Xtriker/Lector_RPM/Documentacion/Encoder.jpg

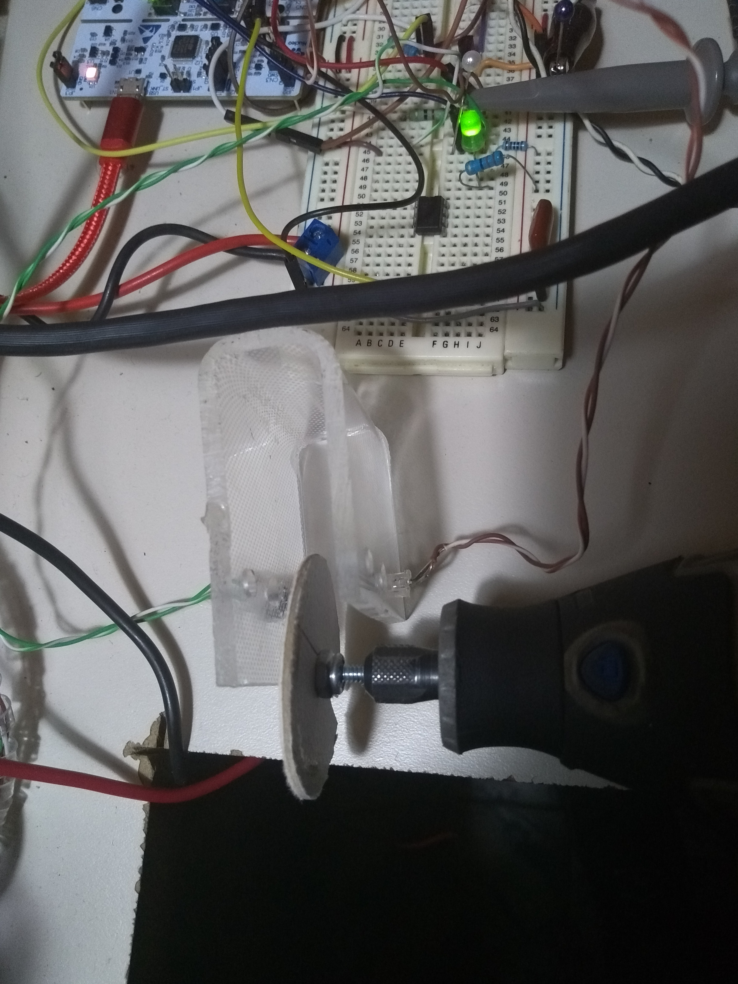
Documentacion/Encoder.jpg
