Xtriker/Lector_RPM/Documentacion/Lectura.jpg

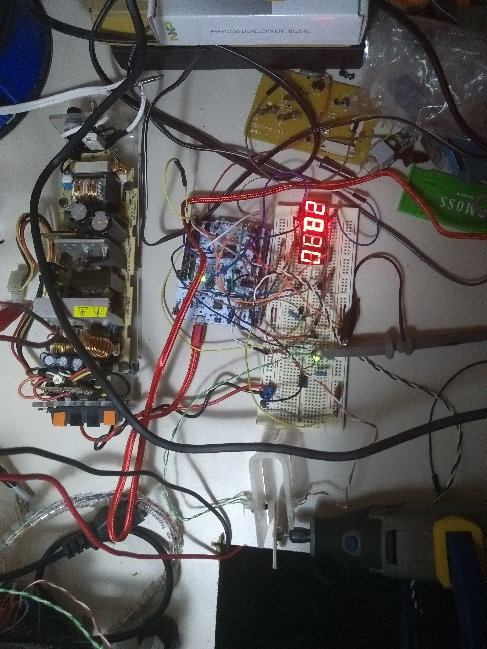
Documentacion/Lectura.jpg
