Xtriker/Lector_RPM/Documentacion/Esquematico.png

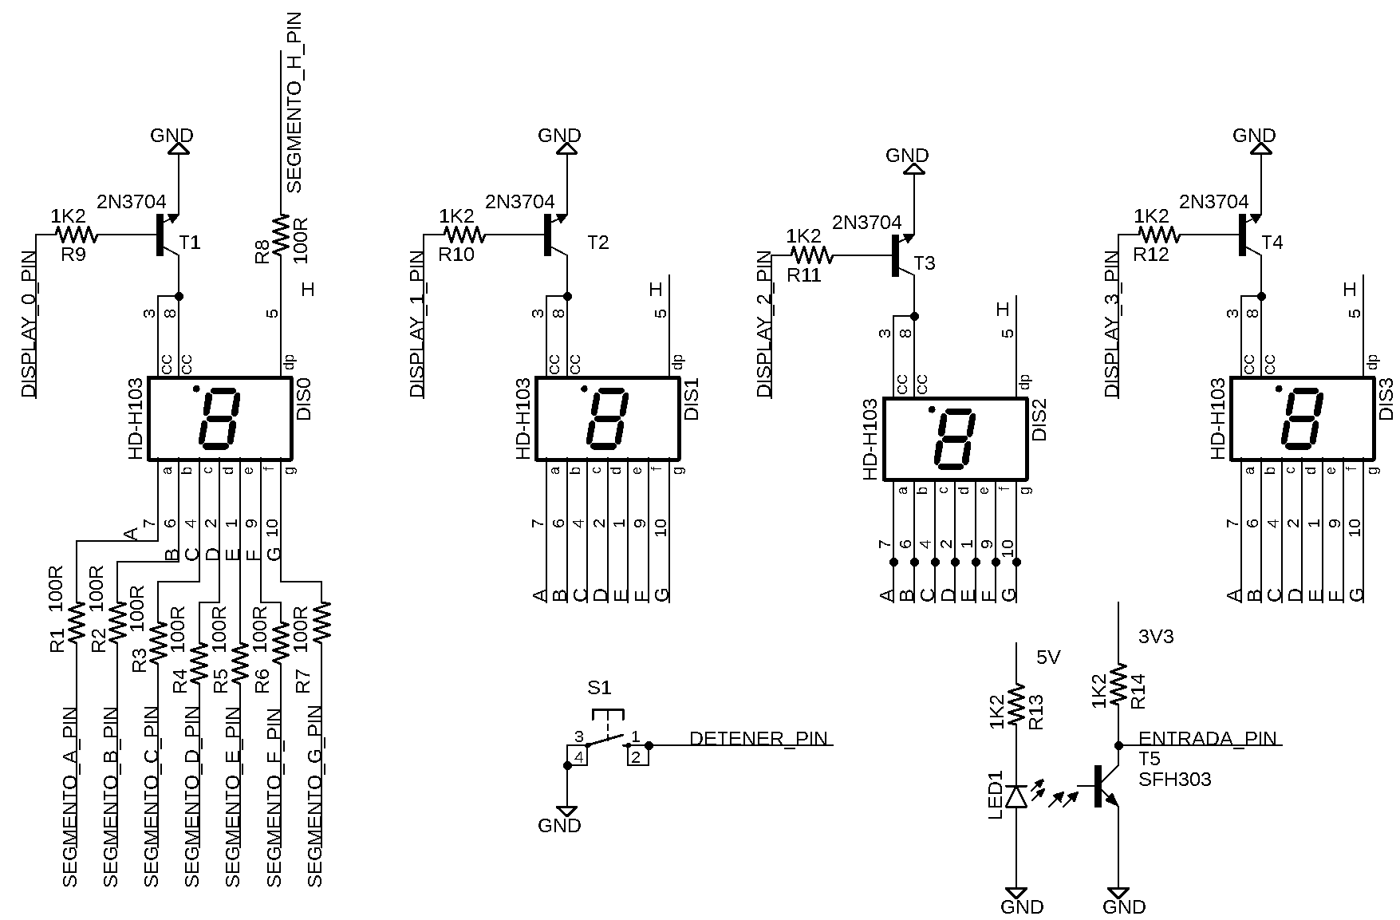
Documentacion/Esquematico.png
