Xtriker/Lector_RPM/Documentacion/IMG_20200613_205311_LL.jpg

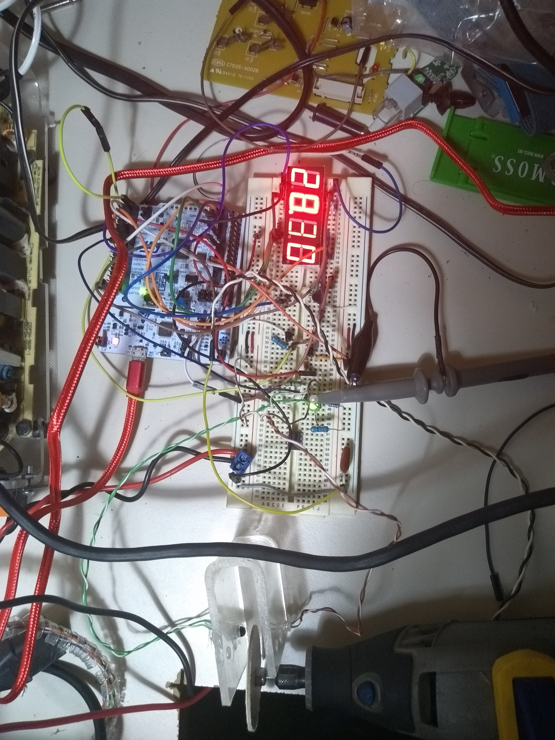
Documentacion/IMG_20200613_205311_LL.jpg
