Xtriker/Lector_RPM/Documentacion/Librerias.png

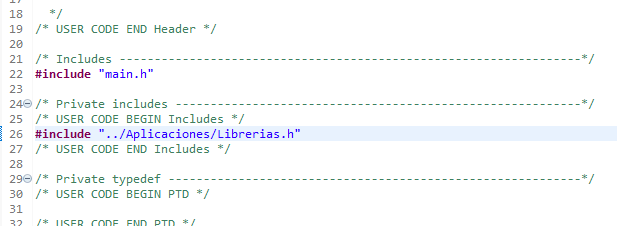
Documentacion/Librerias.png
