Xtriker/Lector_RPM/Documentacion/PIN_OUT.png

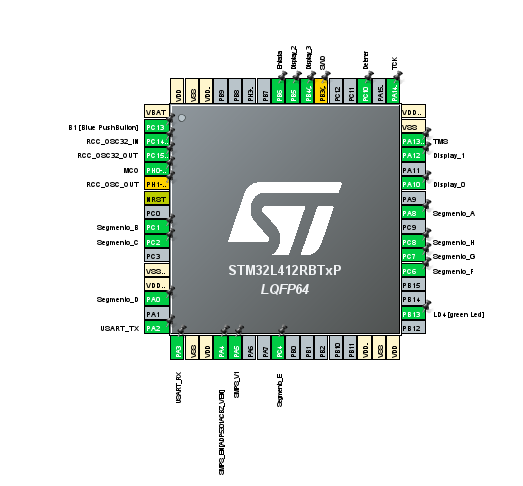
Documentacion/PIN_OUT.png
