Xtriker/Lector_RPM/Documentacion/Timer.png

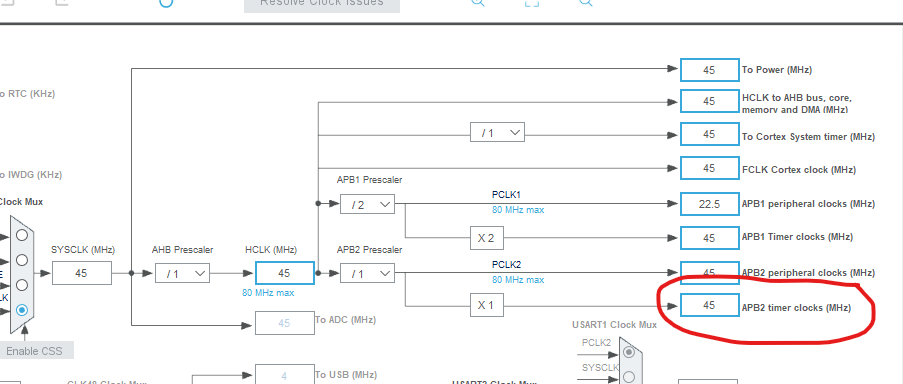
Documentacion/Timer.png
