Xtriker/Lector_RPM/Nucle-64-Template/STM32-Nucleo-F401RE-Dimensi.png

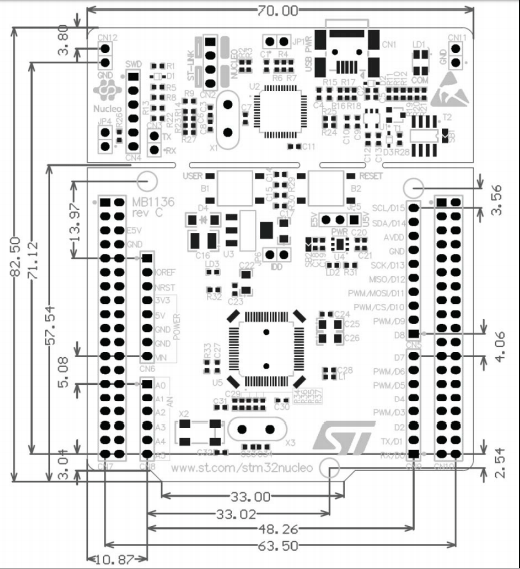
Nucle-64-Template/STM32-Nucleo-F401RE-Dimensi.png
