Xtriker/Lector_RPM/Documentacion/Curva_de_calibracion_frecuencia_vs_contador.ods

Hz | Contador 1us
20 | 49970 | 6255.8303561212 | 16.5546841464361
21 | 47590 | 5149.88924567352 | 18.4109547114658
22 | 47427 | 5080.05383219248 | 18.5454499022332
23 | 43452 | 3588.40142224915 | 22.1474977617652
24 | 41642 | 3031.72301653417 | 24.0118736901585
25 | 39976 | 2579.47229660204 | 25.8663314078583
26 | 38438 | 2209.16167197197 | 27.7052017611557
27 | 37015 | 1903.92559533439 | 29.5228036710998
30 | 33313 | 1260.11223473255 | 34.8297690131176
40 | 24985 | 429.774660765742 | 50.5191163300102
50 | 19988 | 210.963856136846 | 63.1484528349818
60 | 16656 | 137.475969805337 | 73.2791274527755
70 | 14277 | 110.945830610915 | 81.4922496657007
80 | 12492 | 103.246777688146 | 88.2536884074348
90 | 11104 | 104.297685583511 | 93.8967131754702
100 | 9994 | 109.768159636651 | -336.156169875886
150 | 6662 | 155.246623025318 | -324.053727660559
200 | 4997 | 198.808545965195 | -323.202847509546
250 | 3997 | 233.721211319753 | -301.494215569303
300 | 3331 | 261.255251626297 | -290.942408974155
350 | 2855 | 283.265259536837 | -280.816569149962
400 | 2498 | 301.145625761741 | -271.086854483398
450 | 2220 | 315.929902248766 | -261.731471689545
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
