Xtriker/Lector_RPM/Documentacion/Curva_de_calibracion_fase_vs_tiempo.ods

Angulo | Tiempo | Periodo
5 | 0.000231481481481 | 0.008333333333333
10 | 0.000462962962963
15 | 0.000694444444444
20 | 0.000925925925926
25 | 0.001157407407407
30 | 0.001388888888889
35 | 0.00162037037037
40 | 0.001851851851852
45 | 0.002083333333333
50 | 0.002314814814815
55 | 0.002546296296296
60 | 0.002777777777778
65 | 0.003009259259259
70 | 0.003240740740741
75 | 0.003472222222222
80 | 0.003703703703704
85 | 0.003935185185185
90 | 0.004166666666667
95 | 0.004398148148148
100 | 0.00462962962963
105 | 0.004861111111111
110 | 0.005092592592593
115 | 0.005324074074074
120 | 0.005555555555556
125 | 0.005787037037037
130 | 0.006018518518519
135 | 0.00625
140 | 0.006481481481481
145 | 0.006712962962963
150 | 0.006944444444444
155 | 0.007175925925926
160 | 0.007407407407407
165 | 0.007638888888889
170 | 0.00787037037037
175 | 0.008101851851852
180 | 0.008333333333333
