Xtriker/Lector_RPM/Documentacion/Nucle64-template.pdf

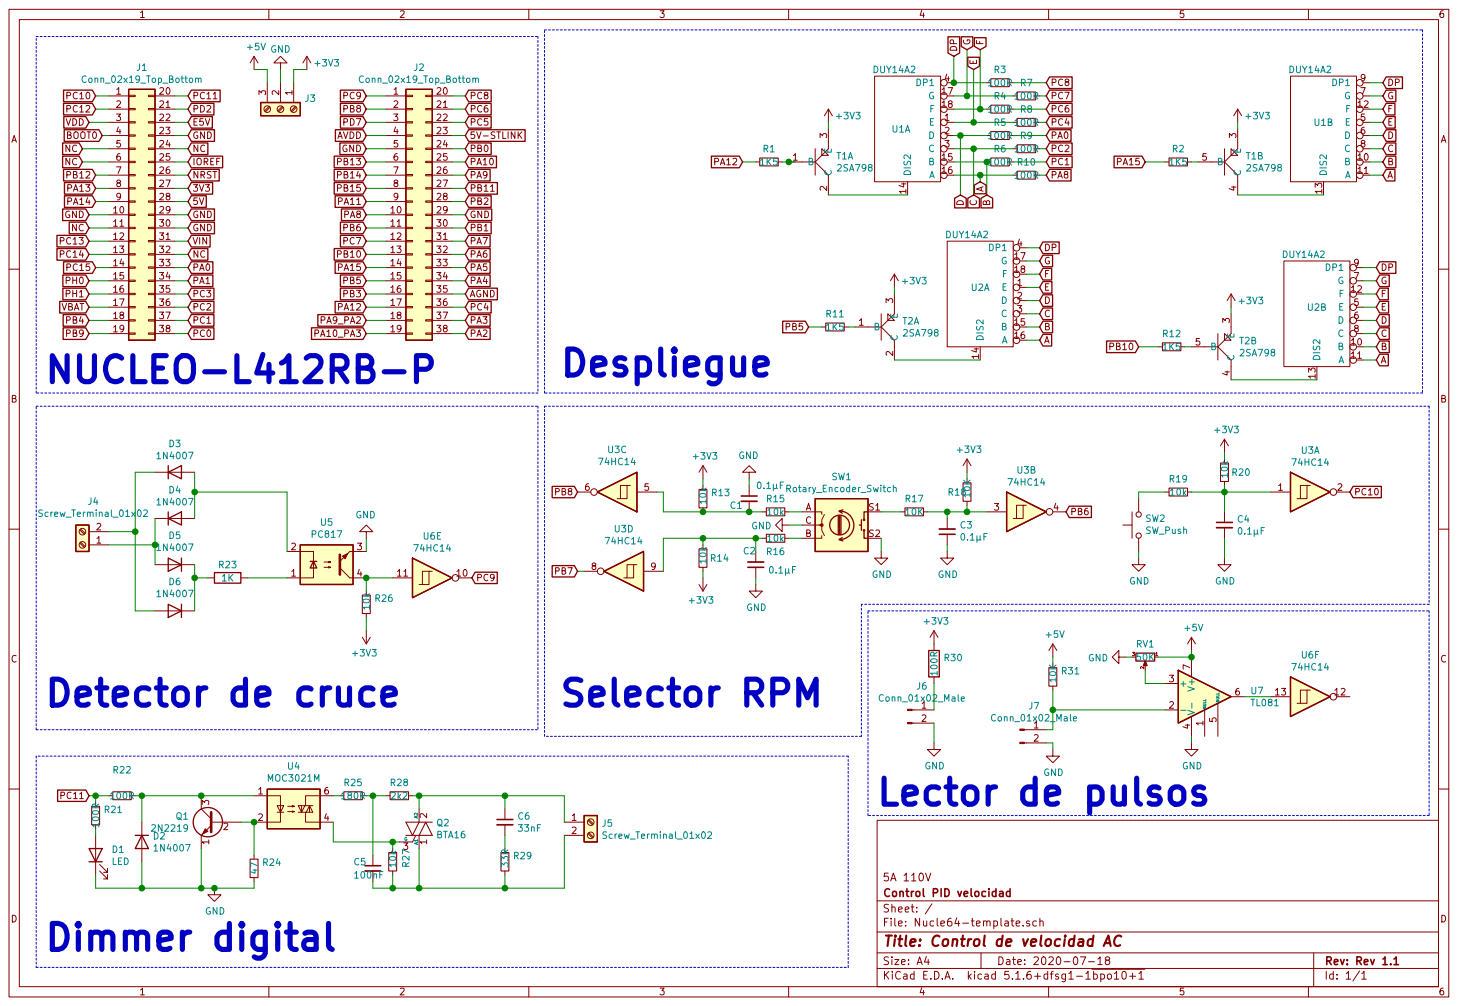
[picture p9: page 1]

File: Nucle64-template.sch Sheet: / Control PID velocidad 5A 110V

Id: 1/1 Title: Control de velocidad AC
