Xtriker/Lector_RPM/Nucle-64-Template/Nucle64-template/Nucle64-template.kicad_pcb

## KiCad design Nucle-64-Template/Nucle64-template/Nucle64-template.kicad_pcb (2020-07-22)

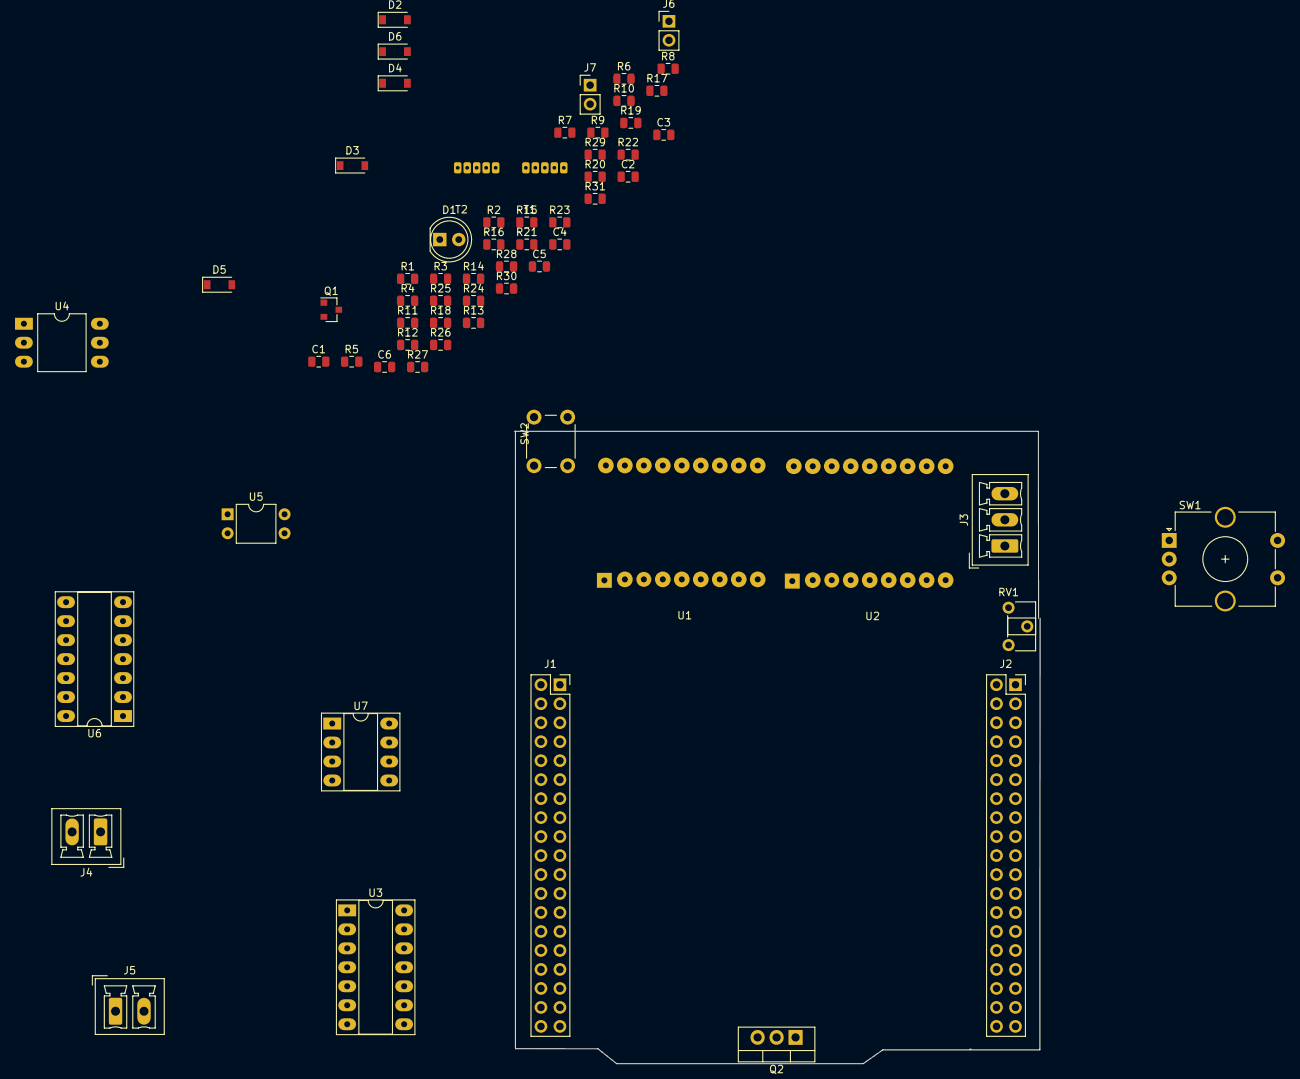
[picture p10: board Nucle64-template.kicad_pcb from above]

Board: 2 copper layers, 70.3 x 84.6 mm, 64 parts (0 on the bottom side), 64 nets, no tracks yet.

Parts:
C1, C2, C3, C4: 0.1µF; C_0805_2012Metric
C5: 100nF; C_0805_2012Metric
C6: 33nF; C_0805_2012Metric
D1: LED; LED_D5.0mm
D2, D3, D4, D5, D6: 1N4007; D_SOD-123
J1, J2: Conn_02x19_Top_Bottom; PinSocket_2x19_P2.54mm_Vertical
J3: Screw_Terminal_01x03; PhoenixContact_MCV_1,5_3-G-3.5_1x03_P3.50mm_Vertical
J4, J5: Screw_Terminal_01x02; PhoenixContact_MCV_1,5_2-G-3.81_1x02_P3.81mm_Vertical
J6, J7: Conn_01x02_Male; PinHeader_1x02_P2.54mm_Vertical
Q1: 2N2219; SOT-23
Q2: BTA16; TO-220-3_Vertical
R1, R2, R11, R12: 1K5; R_0805_2012Metric
R3, R4, R5, R6, R7, R8, R9, R10, R21, R22, R30: 100R; R_0805_2012Metric
R13, R14, R15, R16, R19, R20, R26, R27: 10k; R_0805_2012Metric
R17, R18, R31: 10K; R_0805_2012Metric
R23: 1K; R_0805_2012Metric
R24: 47; R_0805_2012Metric
R25: 180R; R_0805_2012Metric
R28: 2k2; R_0805_2012Metric
R29: 33R; R_0805_2012Metric
RV1: 50K; Potentiometer_ACP_CA6-H2,5_Horizontal
SW1: Rotary_Encoder_Switch; RotaryEncoder_Alps_EC12E-Switch_Vertical_H20mm_CircularMoun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
SW2: SW_Push; SW_PUSH_6mm
T1, T2: 2SA798
U1, U2: DUY14A2
U3, U6: 74HC14; DIP-14_W7.62mm_Socket_LongPads
U4: MOC3021M; DIP-6_W10.16mm_LongPads
U5: PC817; DIP-4_W7.62mm
U7: TL081; DIP-8_W7.62mm_Socket_LongPads

Connections:
+3V3: J3.1, R13.1, R14.2, R18.1, R20.1, R26.2, R30.1, T1.3, T2.3
+5V: J3.3, R31.1, RV1.1, U7.7
A: R10.2, U1.11, U1.16, U2.11, U2.16
B: R6.2, U1.10, U1.15, U2.10, U2.15
C: R9.2, U1.3, U1.8, U2.3, U2.8
D: R5.2, U1.2, U1.6, U2.2, U2.6
DP: R3.2, U1.4, U1.9, U2.4, U2.9
E: R8.2, U1.1, U1.5, U2.1, U2.5
F: R4.2, U1.12, U1.18, U2.12, U2.18
G: R7.2, U1.7, U1.17, U2.7, U2.17
GND: C1.1, C2.1, C3.1, C4.2, D1.1, D2.2, J1.10, J1.23, J1.29, J1.30, J2.5, J2.29, J3.2, J6.2, J7.2, Q1.1, R24.2, RV1.3, SW1.C, SW1.S2, SW2.1, U5.3, U7.4
NC: J1.5, J1.6, J1.11, J1.24, J1.32
unnamed: C1.2, R13.2, R15.2, U3.5
unnamed: C2.2, R14.1, R16.2, U3.9
unnamed: C3.2, R17.1, R18.2, U3.3
unnamed: C4.1, R19.1, R20.2, U3.1
unnamed: C5.1, R25.1, R28.2
unnamed: C5.2, J5.2, Q2.1, R27.2, R29.2
unnamed: C6.1, J5.1, Q2.2, R28.1
unnamed: C6.2, R29.1
unnamed: D1.2, R21.2
unnamed: D2.1, Q1.3, R22.1, U4.1
unnamed: D3.1, D6.2, J4.2
unnamed: D3.2, D4.2, U5.2
unnamed: D4.1, D5.2, J4.1
unnamed: D5.1, D6.1, R23.2
unnamed: J6.1, R30.2
unnamed: J7.1, R31.2, U7.2
unnamed: Q1.2, R24.1, U4.2
unnamed: Q2.3, R27.1, U4.4
unnamed: R1.1, T1.1
unnamed: R2.1, T1.5
unnamed: R11.1, T2.1
unnamed: R12.1, T2.5
unnamed: R15.1, SW1.A
unnamed: R16.1, SW1.B
unnamed: R17.2, SW1.S1
unnamed: R19.2, SW2.2
unnamed: R23.1, U5.1
unnamed: R25.2, U4.6
unnamed: R26.1, U5.4, U6.11
unnamed: RV1.2, U7.3
unnamed: T1.2, U1.14
unnamed: T1.4, U1.13
unnamed: T2.2, U2.14
unnamed: T2.4, U2.13
unnamed: U6.13, U7.6
PA0: J1.33, R5.1
PA8: J2.10, R10.1
PA12: J2.17, R1.2
PA15: J2.14, R2.2
PB5: J2.15, R11.2
PB6: J2.11, U3.4
PB8: J2.2, U3.6
PB10: J2.13, R12.2
PC1: J1.37, R6.1
PC2: J1.36, R9.1
PC4: J2.36, R8.1
PC6: J2.21, R4.1
PC7: J2.12, R7.1
PC8: J2.20, R3.1
PC9: J2.1, U6.10
PC10: J1.1, U3.2
PC11: J1.20, R21.1, R22.2
