Xtriker/Lector_RPM/Control_PID_STM32F103/Core/Src/main.c

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

/* Includes ------------------------------------------------------------------*/
#include "main.h"

/* USER CODE BEGIN Includes */
#include "../../Aplicaciones/app_Debounce.h"
#include "../../Aplicaciones/app_Delay.h"
#include "../../Aplicaciones/app_MAX7219.h"
/* USER CODE END Includes */

SPI_HandleTypeDef hspi1;

TIM_HandleTypeDef htim1;

void SystemClock_Config(void);
static void MX_GPIO_Init(void);
static void MX_TIM1_Init(void);
static void MX_SPI1_Init(void);
/**
  * @brief  The application entry point.
  * @retval int
  */
int main(void)
{
  /* MCU Configuration--------------------------------------------------------*/

  /* Reset of all peripherals, Initializes the Flash interface and the Systick. */
  HAL_Init();

  /* Configure the system clock */
  SystemClock_Config();

  /* Initialize all configured peripherals */
  MX_GPIO_Init();
  MX_TIM1_Init();
  MX_SPI1_Init();
  /* USER CODE BEGIN 2 */
  __HAL_SPI_ENABLE(&hspi1);
  HAL_TIM_Base_Start_IT(&htim1);
  app_InitMAX7219();
  /* USER CODE END 2 */

  /* Infinite loop */
  /* USER CODE BEGIN WHILE */
  /* Se manda la direccion del Boton */
  uint16_t Boton[3] = {0x1000, 0x2000, 0x4000};

  while (1)
  {
	  app_Debounce(Boton, 2);
	  app_SeleccionarAngulo();
	  app_NumeroAMAX7219(Total, 4);
    /* USER CODE END WHILE */

    /* USER CODE BEGIN 3 */
  }
  /* USER CODE END 3 */
}

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
