Xtriker/Lector_RPM/Control_PID_STM32F103/Core/Inc/main.h

#define LED_Pin GPIO_PIN_13
#define LED_GPIO_Port GPIOC
#define CSS_Pin GPIO_PIN_4
#define CSS_GPIO_Port GPIOA
#define Boton0_Pin GPIO_PIN_12
#define Boton0_GPIO_Port GPIOB
#define Boton1_Pin GPIO_PIN_13
#define Boton1_GPIO_Port GPIOB
#define Boton2_Pin GPIO_PIN_14
#define Boton2_GPIO_Port GPIOB
