Xtriker/Lector_RPM/PID_Spindle_Controller/Core/Aplicaciones/app_Despliegue.c

/* Libreria realizada por Adrián Darío Díaz López */
/* Libreria necesaria para el funcionamiento de la libreria */
/* La libreria es para display de 7 segmentos de catodo comun
 * si se quiere usar para anodo es necesario cambiar los 0 por
 * los unos en la funcion app_NumeroA7Segmentos, app_SeleccionDisplay
 * app_FloatADisplay y app_LetrasADisplay.
 */
#include "app_Despliegue.h"

/* Variables globales */
uint8_t Bandera[]={0,0,0};

/* Conversion del valor numerico para 7 segmentos */
void app_NumeroA7Segmentos(uint8_t Numero)
{
	switch(Numero)
	{
		case 0:
		{
			HAL_GPIO_WritePin(Segmento_A_GPIO_Port, Segmento_A_Pin, 1);
			HAL_GPIO_WritePin(Segmento_B_GPIO_Port, Segmento_B_Pin, 1);
			HAL_GPIO_WritePin(Segmento_C_GPIO_Port, Segmento_C_Pin, 1);
			HAL_GPIO_WritePin(Segmento_D_GPIO_Port, Segmento_D_Pin, 1);
			HAL_GPIO_WritePin(Segmento_E_GPIO_Port, Segmento_E_Pin, 1);
			HAL_GPIO_WritePin(Segmento_F_GPIO_Port, Segmento_F_Pin, 1);
			HAL_GPIO_WritePin(Segmento_G_GPIO_Port, Segmento_G_Pin, 0);

		}break;
		case 1:
		{
			HAL_GPIO_WritePin(Segmento_A_GPIO_Port, Segmento_A_Pin, 0);
			HAL_GPIO_WritePin(Segmento_B_GPIO_Port, Segmento_B_Pin, 1);
			HAL_GPIO_WritePin(Segmento_C_GPIO_Port, Segmento_C_Pin, 1);
			HAL_GPIO_WritePin(Segmento_D_GPIO_Port, Segmento_D_Pin, 0);
			HAL_GPIO_WritePin(Segmento_E_GPIO_Port, Segmento_E_Pin, 0);
			HAL_GPIO_WritePin(Segmento_F_GPIO_Port, Segmento_F_Pin, 0);
			HAL_GPIO_WritePin(Segmento_G_GPIO_Port, Segmento_G_Pin, 0);
		}break;
		case 2:
		{
			HAL_GPIO_WritePin(Segmento_A_GPIO_Port, Segmento_A_Pin, 1);
			HAL_GPIO_WritePin(Segmento_B_GPIO_Port, Segmento_B_Pin, 1);
			HAL_GPIO_WritePin(Segmento_C_GPIO_Port, Segmento_C_Pin, 0);
			HAL_GPIO_WritePin(Segmento_D_GPIO_Port, Segmento_D_Pin, 1);
			HAL_GPIO_WritePin(Segmento_E_GPIO_Port, Segmento_E_Pin, 1);
			HAL_GPIO_WritePin(Segmento_F_GPIO_Port, Segmento_F_Pin, 0);
			HAL_GPIO_WritePin(Segmento_G_GPIO_Port, Segmento_G_Pin, 1);
		}break;
		case 3:
		{
			HAL_GPIO_WritePin(Segmento_A_GPIO_Port, Segmento_A_Pin, 1);
			HAL_GPIO_WritePin(Segmento_B_GPIO_Port, Segmento_B_Pin, 1);
			HAL_GPIO_WritePin(Segmento_C_GPIO_Port, Segmento_C_Pin, 1);
			HAL_GPIO_WritePin(Segmento_D_GPIO_Port, Segmento_D_Pin, 1);
			HAL_GPIO_WritePin(Segmento_E_GPIO_Port, Segmento_E_Pin, 0);
			HAL_GPIO_WritePin(Segmento_F_GPIO_Port, Segmento_F_Pin, 0);
			HAL_GPIO_WritePin(Segmento_G_GPIO_Port, Segmento_G_Pin, 1);
		}break;
		case 4:
		{
			HAL_GPIO_WritePin(Segmento_A_GPIO_Port, Segmento_A_Pin, 0);
			HAL_GPIO_WritePin(Segmento_B_GPIO_Port, Segmento_B_Pin, 1);
			HAL_GPIO_WritePin(Segmento_C_GPIO_Port, Segmento_C_Pin, 1);
			HAL_GPIO_WritePin(Segmento_D_GPIO_Port, Segmento_D_Pin, 0);
			HAL_GPIO_WritePin(Segmento_E_GPIO_Port, Segmento_E_Pin, 0);
			HAL_GPIO_WritePin(Segmento_F_GPIO_Port, Segmento_F_Pin, 1);
			HAL_GPIO_WritePin(Segmento_G_GPIO_Port, Segmento_G_Pin, 1);
		}break;
		case 5:
		{
			HAL_GPIO_WritePin(Segmento_A_GPIO_Port, Segmento_A_Pin, 1);
			HAL_GPIO_WritePin(Segmento_B_GPIO_Port, Segmento_B_Pin, 0);
			HAL_GPIO_WritePin(Segmento_C_GPIO_Port, Segmento_C_Pin, 1);
			HAL_GPIO_WritePin(Segmento_D_GPIO_Port, Segmento_D_Pin, 1);
			HAL_GPIO_WritePin(Segmento_E_GPIO_Port, Segmento_E_Pin, 0);
			HAL_GPIO_WritePin(Segmento_F_GPIO_Port, Segmento_F_Pin, 1);
			HAL_GPIO_WritePin(Segmento_G_GPIO_Port, Segmento_G_Pin, 1);
		}break;
		case 6:
		{
			HAL_GPIO_WritePin(Segmento_A_GPIO_Port, Segmento_A_Pin, 1);
			HAL_GPIO_WritePin(Segmento_B_GPIO_Port, Segmento_B_Pin, 0);
			HAL_GPIO_WritePin(Segmento_C_GPIO_Port, Segmento_C_Pin, 1);
			HAL_GPIO_WritePin(Segmento_D_GPIO_Port, Segmento_D_Pin, 1);
			HAL_GPIO_WritePin(Segmento_E_GPIO_Port, Segmento_E_Pin, 1);
			HAL_GPIO_WritePin(Segmento_F_GPIO_Port, Segmento_F_Pin, 1);
			HAL_GPIO_WritePin(Segmento_G_GPIO_Port, Segmento_G_Pin, 1);
		}break;
		case 7:
		{
			HAL_GPIO_WritePin(Segmento_A_GPIO_Port, Segmento_A_Pin, 1);
			HAL_GPIO_WritePin(Segmento_B_GPIO_Port, Segmento_B_Pin, 1);
			HAL_GPIO_WritePin(Segmento_C_GPIO_Port, Segmento_C_Pin, 1);
			HAL_GPIO_WritePin(Segmento_D_GPIO_Port, Segmento_D_Pin, 0);
			HAL_GPIO_WritePin(Segmento_E_GPIO_Port, Segmento_E_Pin, 0);
			HAL_GPIO_WritePin(Segmento_F_GPIO_Port, Segmento_F_Pin, 0);
			HAL_GPIO_WritePin(Segmento_G_GPIO_Port, Segmento_G_Pin, 1);
		}break;
		case 8:
		{
			HAL_GPIO_WritePin(Segmento_A_GPIO_Port, Segmento_A_Pin, 1);
			HAL_GPIO_WritePin(Segmento_B_GPIO_Port, Segmento_B_Pin, 1);
			HAL_GPIO_WritePin(Segmento_C_GPIO_Port, Segmento_C_Pin, 1);
			HAL_GPIO_WritePin(Segmento_D_GPIO_Port, Segmento_D_Pin, 1);
			HAL_GPIO_WritePin(Segmento_E_GPIO_Port, Segmento_E_Pin, 1);
			HAL_GPIO_WritePin(Segmento_F_GPIO_Port, Segmento_F_Pin, 1);
			HAL_GPIO_WritePin(Segmento_G_GPIO_Port, Segmento_G_Pin, 1);
		}break;
		case 9:
		{
			HAL_GPIO_WritePin(Segmento_A_GPIO_Port, Segmento_A_Pin, 1);
			HAL_GPIO_WritePin(Segmento_B_GPIO_Port, Segmento_B_Pin, 1);
			HAL_GPIO_WritePin(Segmento_C_GPIO_Port, Segmento_C_Pin, 1);
			HAL_GPIO_WritePin(Segmento_D_GPIO_Port, Segmento_D_Pin, 1);
			HAL_GPIO_WritePin(Segmento_E_GPIO_Port, Segmento_E_Pin, 0);
			HAL_GPIO_WritePin(Segmento_F_GPIO_Port, Segmento_F_Pin, 1);
			HAL_GPIO_WritePin(Segmento_G_GPIO_Port, Segmento_G_Pin, 1);
		}break;
		default:
		{

			/*No hace nada */
		}
	}
}

/* Seleccion del display, su uso es para 4 displays de 7 segmentos */
/* Es necesario el usado de transistores */
void app_SeleccionDisplay(uint8_t Display)
{
	switch(Display)
	{
		case 0:
			{
				HAL_GPIO_WritePin(Display_0_GPIO_Port, Display_0_Pin, 1);
				HAL_GPIO_WritePin(Display_1_GPIO_Port, Display_1_Pin, 0);
				HAL_GPIO_WritePin(Display_2_GPIO_Port, Display_2_Pin, 0);
				HAL_GPIO_WritePin(Display_3_GPIO_Port, Display_3_Pin, 0);
			}break;
		case 1:
			{
				HAL_GPIO_WritePin(Display_0_GPIO_Port, Display_0_Pin, 0);
				HAL_GPIO_WritePin(Display_1_GPIO_Port, Display_1_Pin, 1);
				HAL_GPIO_WritePin(Display_2_GPIO_Port, Display_2_Pin, 0);
				HAL_GPIO_WritePin(Display_3_GPIO_Port, Display_3_Pin, 0);
			}break;
		case 2:
			{
				HAL_GPIO_WritePin(Display_0_GPIO_Port, Display_0_Pin, 0);
				HAL_GPIO_WritePin(Display_1_GPIO_Port, Display_1_Pin, 0);
				HAL_GPIO_WritePin(Display_2_GPIO_Port, Display_2_Pin, 1);
				HAL_GPIO_WritePin(Display_3_GPIO_Port, Display_3_Pin, 0);
			}break;
		case 3:
			{
				HAL_GPIO_WritePin(Display_0_GPIO_Port, Display_0_Pin, 0);
				HAL_GPIO_WritePin(Display_1_GPIO_Port, Display_1_Pin, 0);
				HAL_GPIO_WritePin(Display_2_GPIO_Port, Display_2_Pin, 0);
				HAL_GPIO_WritePin(Display_3_GPIO_Port, Display_3_Pin, 1);
			}break;
		default:
		{
			/* Envia todos los displays a 1 logicos */
			HAL_GPIO_WritePin(Display_0_GPIO_Port, Display_0_Pin, 1);
			HAL_GPIO_WritePin(Display_1_GPIO_Port, Display_1_Pin, 1);
			HAL_GPIO_WritePin(Display_2_GPIO_Port, Display_2_Pin, 1);
			HAL_GPIO_WritePin(Display_3_GPIO_Port, Display_3_Pin, 1);
		}
	}
}

/* Separacion de numero en unidades, decenas, centenas ... */
void app_Despliegue(uint16_t Numero)
{
	uint8_t Primero  =  Numero % 10;
	uint8_t Segundo =  ( Numero - Primero ) % 100 / 10;
	uint8_t Tercero  =  ( Numero - Primero - Segundo ) % 1000 / 100;
	uint8_t Cuarto =  ( Numero - Primero - Segundo - Tercero ) % 10000 / 1000;
	uint8_t Quinto = (Numero - Primero - Segundo - Tercero - Cuarto) % 100000 / 10000;
	if (Numero > 9999)
	{
		HAL_GPIO_WritePin(Segmento_H_GPIO_Port, Segmento_H_Pin, 0);
		app_SeleccionDisplay(0);
		app_NumeroA7Segmentos(Quinto);
		HAL_Delay(3);

		app_SeleccionDisplay(1);
		app_NumeroA7Segmentos(Cuarto);

		HAL_Delay(3);
		app_SeleccionDisplay(2);
		app_NumeroA7Segmentos(Tercero);
		HAL_Delay(3);
		app_SeleccionDisplay(3);
		app_NumeroA7Segmentos(Segundo);
		HAL_Delay(3);
		app_SeleccionDisplay(1);
		//app_NumeroA7Segmentos(Cuarto);
		HAL_GPIO_WritePin(Segmento_H_GPIO_Port, Segmento_H_Pin, 1);
		HAL_Delay(3);

	}
	if(Numero < 9999)
	{


		HAL_GPIO_WritePin(Segmento_H_GPIO_Port, Segmento_H_Pin, 0);
		app_SeleccionDisplay(0);
		app_NumeroA7Segmentos(Cuarto);
		HAL_Delay(3);
		app_SeleccionDisplay(1);
		app_NumeroA7Segmentos(Tercero);
		HAL_Delay(3);
		app_SeleccionDisplay(2);
		app_NumeroA7Segmentos(Segundo);
		HAL_Delay(3);
		app_SeleccionDisplay(3);
		app_NumeroA7Segmentos(Primero);
		HAL_Delay(3);
		if(Bandera[0] == 1)
		{
			app_SeleccionDisplay(0);
			app_NumeroA7Segmentos(Cuarto);
			HAL_GPIO_WritePin(Segmento_H_GPIO_Port, Segmento_H_Pin, 1);
			HAL_Delay(3);
		}
		if(Bandera[1] == 1)
		{
			app_SeleccionDisplay(1);
			HAL_GPIO_WritePin(Segmento_H_GPIO_Port, Segmento_H_Pin, 1);
			app_NumeroA7Segmentos(Tercero);
			HAL_Delay(3);
		}
		if(Bandera[2] == 1)
		{
			app_SeleccionDisplay(2);
			HAL_GPIO_WritePin(Segmento_H_GPIO_Port, Segmento_H_Pin, 1);
			app_NumeroA7Segmentos(Segundo);
			HAL_Delay(3);
		}
	}

}

/* Conversion de datos flotantes a displays de 7 segmentos */
void app_FloatADisplay(float NumeroFlotante) //125.8
{
	volatile int Numero = 0;


	if( (NumeroFlotante > 0.0) && (NumeroFlotante < 10.0))
		{
			Bandera[0] = 1;
			Bandera[1] = 0;
			Bandera[2] = 0;
			Numero = NumeroFlotante * 1000;
		}
	else if( (NumeroFlotante > 10.0) && (NumeroFlotante < 100.0)) //54.87
		{
			Bandera[0] = 0;
			Bandera[1] = 1;
			Bandera[2] = 0;
			Numero = NumeroFlotante * 100; //5487
		}
	else if( (NumeroFlotante > 100.0) && (NumeroFlotante < 1000.0))
		{
			Bandera[0] = 0;
			Bandera[1] = 0;
			Bandera[2] = 1;
			Numero = NumeroFlotante * 10;
		}
	app_Despliegue(Numero);

}

/* Impresion de letras en display de 7 segmentos */
void app_LetrasADisplay(char Letras)
{
	//volatile uint8_t i=0;
	switch(Letras)
		{
			case 'A' | 'a':
			{
				HAL_GPIO_WritePin(Segmento_A_GPIO_Port, Segmento_A_Pin, 1);
				HAL_GPIO_WritePin(Segmento_B_GPIO_Port, Segmento_B_Pin, 1);
				HAL_GPIO_WritePin(Segmento_C_GPIO_Port, Segmento_C_Pin, 1);
				HAL_GPIO_WritePin(Segmento_D_GPIO_Port, Segmento_D_Pin, 0);
				HAL_GPIO_WritePin(Segmento_E_GPIO_Port, Segmento_E_Pin, 1);
				HAL_GPIO_WritePin(Segmento_F_GPIO_Port, Segmento_F_Pin, 1);
				HAL_GPIO_WritePin(Segmento_G_GPIO_Port, Segmento_G_Pin, 1);

			}break;
			case 'B' | 'b':
			{
				HAL_GPIO_WritePin(Segmento_A_GPIO_Port, Segmento_A_Pin, 0);
				HAL_GPIO_WritePin(Segmento_B_GPIO_Port, Segmento_B_Pin, 0);
				HAL_GPIO_WritePin(Segmento_C_GPIO_Port, Segmento_C_Pin, 1);
				HAL_GPIO_WritePin(Segmento_D_GPIO_Port, Segmento_D_Pin, 1);
				HAL_GPIO_WritePin(Segmento_E_GPIO_Port, Segmento_E_Pin, 1);
				HAL_GPIO_WritePin(Segmento_F_GPIO_Port, Segmento_F_Pin, 1);
				HAL_GPIO_WritePin(Segmento_G_GPIO_Port, Segmento_G_Pin, 1);
			}break;
			case 'C' | 'c':
			{
				HAL_GPIO_WritePin(Segmento_A_GPIO_Port, Segmento_A_Pin, 1);
				HAL_GPIO_WritePin(Segmento_B_GPIO_Port, Segmento_B_Pin, 0);
				HAL_GPIO_WritePin(Segmento_C_GPIO_Port, Segmento_C_Pin, 0);
				HAL_GPIO_WritePin(Segmento_D_GPIO_Port, Segmento_D_Pin, 1);
				HAL_GPIO_WritePin(Segmento_E_GPIO_Port, Segmento_E_Pin, 1);
				HAL_GPIO_WritePin(Segmento_F_GPIO_Port, Segmento_F_Pin, 1);
				HAL_GPIO_WritePin(Segmento_G_GPIO_Port, Segmento_G_Pin, 0);
			}break;
			case 'D' | 'd':
			{
				HAL_GPIO_WritePin(Segmento_A_GPIO_Port, Segmento_A_Pin, 0);
				HAL_GPIO_WritePin(Segmento_B_GPIO_Port, Segmento_B_Pin, 1);
				HAL_GPIO_WritePin(Segmento_C_GPIO_Port, Segmento_C_Pin, 1);
				HAL_GPIO_WritePin(Segmento_D_GPIO_Port, Segmento_D_Pin, 1);
				HAL_GPIO_WritePin(Segmento_E_GPIO_Port, Segmento_E_Pin, 1);
				HAL_GPIO_WritePin(Segmento_F_GPIO_Port, Segmento_F_Pin, 0);
				HAL_GPIO_WritePin(Segmento_G_GPIO_Port, Segmento_G_Pin, 1);
			}break;
			case 'E' | 'e':
			{
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
				HAL_GPIO_WritePin(Segmento_E_GPIO_Port, Segmento_E_Pin, 0);
				HAL_GPIO_WritePin(Segmento_F_GPIO_Port, Segmento_F_Pin, 1);
				HAL_GPIO_WritePin(Segmento_G_GPIO_Port, Segmento_G_Pin, 1);
			}break;
			default:
			{
				/*No hace nada */
			}
		}
}
