Xtriker/Lector_RPM/Control_PID_STM32F103/Aplicaciones/Macros.h

/*
 * Macros.h
 *
 *  Created on: Jun 26, 2020
 *      Author: dario
 */

#ifndef MACROS_H_
#define MACROS_H_

/* Valores del PID */

#define Kp (float)4.3
#define Ki (float)2.2
#define Kd (float)0.8

#endif /* MACROS_H_ */
