Xtriker/Lector_RPM/PID_Spindle_Controller/Core/Aplicaciones/Librerias.h

/*
 * Libreiras.h
 *
 *  Created on: Jun 14, 2020
 *      Author: Dario
 */

#ifndef LIBRERIAS_H_
#define LIBRERIAS_H_

#include <stdio.h>
#include <math.h>
#include "../Aplicaciones/app_Despliegue.h"
#include "../Aplicaciones/app_Frecuencia.h"


#endif /* LIBRERIAS_H_ */
