Xtriker/Lector_RPM/(commit log)

2020-06-08 Se globaliza librería a STM32F1
    La librería de 7 Segmentos ahora es posible usarla en STM32F103 y STM32L412
2020-06-08 Implementación de función para desplegar letras en display
2020-06-08 Realizacion del ejemplo para la impresion
    Contador de 0 a 999
2020-06-12 Se realiza una maquina de estados
    Se implementa una maquina de estados para la mejor visualización de las revoluciones en el display
2020-06-14 Correcto funcionamiento y prueba del medidor de RPM
    Se realiza la prueba física del medidor de RPM, se desplegan correctamente los datos en el display de 7 segmentos.
    [app_Debounce.c, app_Despliegue.c, app_Frecuencia.c, main.c]
2020-06-14 Pin in/out usados
2020-06-14 Imagen configuracion Timer
2020-06-14 Se coloca diagrama de conexiones
2020-06-14 Corrección en los voltajes del traductor
2020-06-14 Imágenes de la implementación.
2020-06-22 Implementación de controlador PID
    Implementacion de controlador PID en la maquina de estados
2020-06-22 Implementación de interrupcion en PC13
2020-06-24 Implementación del encoder mecanico
    Se coloca un encoder mecánico para cambiar los valores de 0 a 9; en un futuro se usará para cambiar los valores de la RPM en el display de 7 segmentos.
2020-06-24 Implementacion del cambio de valor con el Encoder
    Mediante el encoder e interupciones del sistemas es posible cambiar los valores de lo que sera las variaciones de las RPM del control PID.
2020-06-25 Se colocar libreria PID de github
2020-06-30 Modificación libreria despliegue
    Ahora es posible el uso de ambos tipos de display de 7 segmentos (anodo y catodo) ademas de la implementacion de un 5 displays.
2020-07-01 Correccion de datos flotantes y lectura
    Se realiza correcion de lectura en el display catodo comun de 7 segmentos, ahora se tienen 5 segmentos y un mayor rango de lectura
2020-07-01 Correccion de desbordamiento de datos
    Se corrige error de desbordamiento en la libreria despliegue.h
    [app_Despliegue.c, app_Despliegue.h, main.c, main.h]
2020-07-01 Se establece los limites de las RPM
    Se establece los limites de RPM a 35,000 , para evitar daños en hardware
2020-07-03 Prueba experimental del dimmer y el cruce por cero
2020-07-05 Modificación del tiempo de encendido del SCR y el despliegue
    Se realiza una modificación en la función Espera(); ahora colocando un argumento llamado Tiempo en milisegundos, este parametro es escencial para la activacion del SCR, ademas de implementar el despliegue en el display de 7 segmentos; este despliegue se dará en grados de 0 hasta 180 deacuerdo con la nueva funcion con retorno llamada float app_SeleccionarAngulo(void)
2020-07-07 Correcto funcionamiento del dimmer
    [Librerias.h, main.c]
2020-07-08 Creacion de la libreria de app_SpindleController.h
    Se realizar el controlador PID para un router de 1/4 HP
2020-07-08 Cambio de valores Ki, Kp y Kd
2020-07-09 Solucion de problemas de impresion de digitos en el dimmer
    Se soluciona el pulsado de la carga AC y la impresion de los datos en el display de 7 segmentos
    [RPM Debug.cfg]
2020-07-10 Se realiza libreria app_DigitalDimmer.h
    Se realiza libreria para la realizacion de pruebas, se logro un optimo funcionamiento
    [Curva_de_calibracion_fase_vs_tiempo.ods]
2020-07-13 Cambio de la función de lectura de frecuencia
    Se realiza una nueva forma de realizar la lectura de la frecuencia del spindle, esta nueva forma es mediante interrupciones del timer; minimizando el tiempo de ejecución entre cada una de las tareas.
2020-07-14 Modificación de los Timer, y cambio Debounce
    Se realiza modificación de Tiempo de los TImer, y se realiza una modificación a la función app_Debounce();, la lectura de cada uno de los timers es de 1 ms en el timer1 y de 1us en el timer 2
2020-07-15 Primer prueba fisica del controlador PID
    Es necesario realizar un promedio de las lecturas y cambiar los valores del controlador PID
    [Curva_de_calibracion_frecuencia_vs_contador.ods]
2020-07-15 Se realiza un promedio de la lectura de la frecuencia
2020-07-15 2da prueba del controlador PID
    En esta segunda prueba el controlador se comporto mas responsivo en la lectura de las RPM, es necesario modificador los valores Ki, Dp y Kd
2020-07-18 NUCLEO-L412RB-P Shield
    [Nucle64-template.kicad_pcb, Nucle64-template.sch]
2020-07-19 Creación del digrama esquemático
    [Nucle64-template.kicad_pcb, Nucle64-template.sch]
2020-07-19 Reconfiguracion del timer
2020-07-22 Creación del porteo del controlador PID a STM32F103
2020-07-22 Nueva librerias
    Creación de la librería app_Delay.h, app_Debounce.h y app_MAX7212.h
2020-07-22 Se realizan cambios del porteo de Encoder.h
    [RPM Debug.cfg]
2020-07-23 Se realiza modificación de la libreria app_MAX7912.h
2020-07-24 Implementación de la librería app_MAX7912
    Se realiza prueba física del Encoder y MAX7912
2020-07-24 Cambio de Encoder por Push Botton
