Xtriker/Lector_RPM/(notices)

Notices in the files:
Control_PID_STM32F103/Core/Src/main.c:
© Copyright (c) 2020 STMicroelectronics.
All rights reserved.
This software component is licensed by ST under BSD 3-Clause license,
the "License"; You may not use this file except in compliance with the
License. You may obtain a copy of the License at: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
Control_PID_STM32F103/Core/Inc/main.h:
(C) COPYRIGHT STMicroelectronics *****END OF FILE
